ORPA1988/PiLiDAR/hardware/stl27l_mount.stl

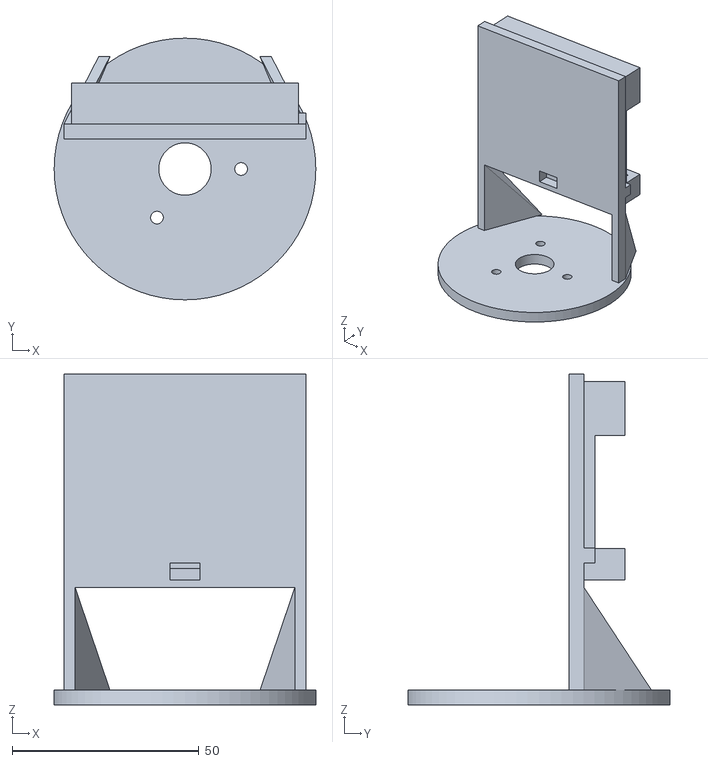
[picture p10: CAD file, 2026-06-21]
hardware/stl27l_mount.stl
70.0 x 70.0 x 88.5
