ORPA1988/PiLiDAR/backend/app.py

"""FastAPI-Server: REST-Steuerung + WebSocket-Rohdatenstream + statisches Frontend.

Start:  uvicorn backend.app:app --host 0.0.0.0 --port 8000
oder:   python -m backend.app
Mock-Modus (ohne Hardware, zum Testen am PC):  PILIDAR_MOCK=1 python -m backend.app
"""

from __future__ import annotations

import asyncio
import os
import subprocess
import time
from pathlib import Path

from fastapi import Body, FastAPI, WebSocket, WebSocketDisconnect
from fastapi.responses import HTMLResponse, JSONResponse, Response
from fastapi.staticfiles import StaticFiles

try:
    import psutil as _psutil
except ImportError:
    _psutil = None

_net_prev: dict = {}  # {iface: (bytes_sent, bytes_recv, timestamp)}

from .config import config
from .controller import ScanController

ROOT = Path(__file__).resolve().parent.parent
FRONTEND = ROOT / "frontend"

FORCE_MOCK = os.environ.get("PILIDAR_MOCK", "0") == "1"

app = FastAPI(title="PiLiDAR", version="2.0")
controller = ScanController(config, force_mock=FORCE_MOCK)

if FORCE_MOCK:
    # Synthetischer LiDAR -> komplette UI ohne Hardware demonstrierbar
    from .hardware.mock_serial import MockLidarSerial
    controller.lidar._serial_factory = lambda: MockLidarSerial()


@app.on_event("startup")
async def _startup():
    controller.bind_loop(asyncio.get_running_loop())


@app.on_event("shutdown")
async def _shutdown():
    controller.close()


# --- REST -------------------------------------------------------------
@app.get("/api/status")
async def api_status():
    return controller.status()


@app.get("/api/config")
async def api_config():
    return config.as_dict()


@app.post("/api/lidar/start")
async def api_lidar_start():
    controller.start_lidar_only()
    return {"ok": True, "state": controller.state}


@app.post("/api/lidar/stop")
async def api_lidar_stop():
    controller.stop_lidar_only()
    return {"ok": True, "state": controller.state}


@app.post("/api/scan/start")
async def api_scan_start(payload: dict | None = None):
    payload = payload or {}
    mode = str(payload.get("mode", "B")).upper()
    name = str(payload.get("name", ""))
    scan_id = controller.start_scan(mode=mode, name=name)
    return {"ok": True, "scan_id": scan_id}


@app.post("/api/scan/stop")
async def api_scan_stop():
    controller.stop()
    return {"ok": True, "state": controller.state}


@app.get("/api/scans")
async def api_scans():
    return controller.store.list_scans()


@app.get("/api/scans/{scan_id}/pointcloud")
async def api_scan_pointcloud(scan_id: str):
    """Gespeicherte Punktwolke für die 3D-Anzeige als kompakter Binär-Buffer.

    Layout (little-endian): uint32 n | float32[n*3] xyz [m] | uint8[n] Intensität.
    Bei Millionen Punkten ist das um Größenordnungen kleiner/schneller als JSON.
    """
    buf = await asyncio.to_thread(controller.store.load_pointcloud_packed, scan_id)
    if len(buf) <= 4:  # nur der n=0-Header => keine Punktwolke
        return JSONResponse(status_code=404, content={"error": "keine Punktwolke"})
    return Response(content=buf, media_type="application/octet-stream")


@app.get("/api/scans/{scan_id}/download")
async def api_scan_download(scan_id: str):
    data = controller.store.zip_bytes(scan_id)
    return Response(content=data, media_type="application/zip",
                    headers={"Content-Disposition": f'attachment; filename="{scan_id}.zip"'})


@app.post("/api/calibrate/rotation")
async def api_cal_rotation():
    result = await asyncio.to_thread(controller.run_rotation_calibration)
    return result


@app.post("/api/calibrate/offset")
async def api_cal_offset():
    result = await asyncio.to_thread(controller.run_offset_calibration)
    return result


@app.get("/api/system/stats")
async def api_system_stats():
    if _psutil is None:
        return {"available": False}
    cpu = _psutil.cpu_percent(interval=None)
    ram = _psutil.virtual_memory().percent
    net: dict = {}
    try:
        counters = _psutil.net_io_counters(pernic=True)
        now = time.monotonic()
        for iface in ("eth0", "wlan0", "bnep0", "end0"):
            if iface not in counters:
                continue
            c = counters[iface]
            if iface in _net_prev:
                prev_sent, prev_recv, prev_t = _net_prev[iface]
                dt = max(1e-3, now - prev_t)
                net[iface] = {
                    "tx_bps": int((c.bytes_sent - prev_sent) / dt),
                    "rx_bps": int((c.bytes_recv - prev_recv) / dt),
                }
            else:
                net[iface] = {"tx_bps": 0, "rx_bps": 0}
            _net_prev[iface] = (c.bytes_sent, c.bytes_recv, now)
    except Exception:
        pass
    return {"available": True, "cpu_percent": cpu, "ram_percent": ram, "net": net}


@app.post("/api/system/reboot")
async def api_reboot():
    subprocess.run(["sudo", "systemctl", "reboot"], check=False)
    return {"ok": True}


@app.post("/api/system/poweroff")
async def api_poweroff():
    subprocess.run(["sudo", "systemctl", "poweroff"], check=False)
    return {"ok": True}


@app.delete("/api/scans/{scan_id}")
async def api_scan_delete(scan_id: str):
    controller.store.delete_scan(scan_id)
    return {"ok": True}


@app.post("/api/scans/{scan_id}/annotation")
async def api_scan_annotation(scan_id: str, payload: dict = Body(...)):
    controller.store.update_annotation(scan_id, str(payload.get("text", "")))
    return {"ok": True}


@app.post("/api/config/apply")
async def api_config_apply(payload: dict):
    """Kalibrierergebnisse übernehmen (z.B. gear_ratio, angle_offset, offsets)."""
    if "gear_ratio" in payload:
        config.update_section("STEPPER", {"GEAR_RATIO": float(payload["gear_ratio"])})
    geom = {}
    if "model_y_offset" in payload:
        geom["MODEL_Y_OFFSET"] = float(payload["model_y_offset"])
    if "model_z_offset" in payload:
        geom["MODEL_Z_OFFSET"] = float(payload["model_z_offset"])
    if geom:
        config.update_section("GEOMETRY", geom)
    if "angle_offset" in payload:
        config.update_section("LIDAR", {"ANGLE_OFFSET": float(payload["angle_offset"])})
    if "overlap_deg" in payload:
        config.update_section("MODE_B_CONTINUOUS", {"OVERLAP_DEG": float(payload["overlap_deg"])})
    return {"ok": True, "config": config.as_dict()}


# --- WebSocket: Rohdaten-Stream --------------------------------------
@app.websocket("/ws/scan")
async def ws_scan(ws: WebSocket):
    await ws.accept()
    q = controller.subscribe()
    # geometrische Parameter einmalig senden, damit der Client rechnen kann
    await ws.send_json({
        "type": "init",
        "angle_offset": config.LIDAR["ANGLE_OFFSET"],
        "model_y": config.GEOMETRY["MODEL_Y_OFFSET"],
        "model_z": config.GEOMETRY["MODEL_Z_OFFSET"],
        "dist_min": config.LIDAR["DISTANCE_MIN_MM"],
        "dist_max": config.LIDAR["DISTANCE_MAX_MM"],
    })
    try:
        while True:
            msg = await q.get()
            await ws.send_json({"type": "frame", **msg})
    except WebSocketDisconnect:
        pass
    finally:
        controller.unsubscribe(q)


# --- statisches Frontend (zuletzt gemountet) -------------------------
if FRONTEND.exists():
    app.mount("/", StaticFiles(directory=str(FRONTEND), html=True), name="frontend")
else:  # pragma: no cover
    @app.get("/")
    async def _root():
        return HTMLResponse("<h1>PiLiDAR</h1><p>Frontend fehlt.</p>")


def main():
    import uvicorn
    uvicorn.run(app, host=config.SERVER["HOST"], port=config.SERVER["PORT"])


if __name__ == "__main__":
    main()
