ORPA1988/PiLiDAR/(commit log)

2025-06-12 Implement relay control and autostart setup
2025-09-17 Add GUI workflow, enhanced LiDAR driver, and documentation overhaul
2026-06-21 PiLiDAR 2.0: Inhalt ersetzt — Web-Steuerung, USB-STL27L, kontinuierliche Drehung
    Vollständige Neuumsetzung (CC BY-NC-SA 4.0):
    - FastAPI-Server (REST + WebSocket), keine Hardware-Knoepfe
    - LiDAR ueber USB; Pi nur Rohdatenerfassung, Client rechnet (WebGL, ohne Install)
    - Modus B: kontinuierliche konstante Drehung via Hardware-PWM (GPIO19)
    - Ein Ordner pro Scan (Rohdaten + Punktwolken), Referenzfahrt, QA, Kalibrierung
    - Parametrischer STL27L-Halter (OpenSCAD) + Doku (Verkabelung, BOM, Konzept)
    [PiLiDAR_BOM_Specs.xlsx, stl27l_mount.scad, stl27l_mount.stl]
2026-06-21 Detailgetreue, pin-genaue Verkabelungspläne (A4988 & TMC2209) ergänzt
    - docs/make_wiring_detailed.py: komplette 40-Pin-Pi-Leiste, voller Treiber-Pinout,
    Kondensatoren an korrekten Knoten, Spulenpaare, Sternmasse, Legende
    - PNG+SVG in docs/images/, ins Konzept-Dokument eingebettet
2026-06-21 Montage- und Scan-Vorgang-Skizze auf technischen Zeichenstil umgestellt
    - lidar_montage: Baugruppen-Schnitt (Y-Z) mit Koordinatentriade, Drehachsen-
    Mittellinie, bemaßtem center_height/axis_offset, Spinachse, Schriftfeld
    - scan_vorgang: Messgeometrie (Scan-Ebene) + Rechenketten-Notizblock, Schriftfeld
    - Konzept-docx mit den neuen technischen Zeichnungen aktualisiert
2026-06-21 Bugfixes, System-Dashboard und Scan-Verwaltung (#31)
    Bugfixes:
    - 3D-Ansicht: _resize() nach Anzeigenwechsel aufrufen + WebGL-Null-Guard
    - QA: Loop-Closure-Residuum wird bei Scans < 350° nicht berechnet (kein falscher Error)
    - Pakete/s: LidarStats.freeze() friert Rate beim Stopp ein (sinkt nicht mehr)
    - Mode A: MAX_PACKAGES wird jetzt tatsächlich abgewartet (Original-Verhalten)
    Neue Features:
    - Dashboard: CPU/RAM/LAN/BT-Bandbreite via psutil (/api/system/stats)
    - Dashboard: LiDAR-Verbindungs-Gesundheitsindikator (grün/gelb/rot)
    - Dashboard: Optimale Mode-B-Geschwindigkeit als Info angezeigt
    - System: Neustart- und Ausschalten-Button (/api/system/reboot, /api/system/poweroff)
    - Scans: Lös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
    [app.py, controller.py, lidar.py, qa.py, storage.py]
2026-06-21 Fix: Mode-B-Geschwindigkeit für gleichen Punktabstand (327 → 1.87 °/s) (#32)
    Der horizontale Punktabstand ergibt sich aus der Plattformdrehung PRO
    LiDAR-Umdrehung (eine vertikale Linie wird nur einmal je Umdrehung
    getroffen), nicht pro Paket. Korrekte Formel:
    SPEED_DPS = Auflösung[°] × Umdrehungsfrequenz[Hz]
    = 0.187° × 10 Hz = 1.87 °/s
    Vorheriger Wert (327 °/s) teilte fälschlich durch die Paketrate und
    hätte ~32.7° Plattformdrehung pro Umdrehung ergeben (extrem grob).
    - config.json: SPEED_DPS 327→1.87, ACCEL_DPS2 1635→10.0
    - app.js: Dashboard-Anzeige der optimalen Geschwindigkeit nutzt jetzt
    die live aus den Frames gemessene Winkelauflösung × Frequenz s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
2026-06-21 LiDAR-Spiegelsteuerung, 3D-Achsen, Scan-Anzeige und 2D/3D-Fix (#33)
    - LiDAR-Spiegel (STL27L): laeuft per Default durch; "0" nur bei "LiDAR stoppen" und Scan-Ende/-Abbruch, "1" nur zum Wieder-Anfahren. Idempotente Motorsteuerung.
    - 2D/3D-Umschaltung repariert (v2d.start/stop, 3D-Resize).
    - 3D-Ansicht: Koordinatenachsen (X/Y/Z) + Labels + Massstab.
    - Gespeicherte Scans in 3D anzeigbar (GET /api/scans/{id}/pointcloud + 3D-Button).
    - Mode-B-Geschwindigkeit 1,67 deg/s (Punktwinkel 0,167 deg x 10 Hz).
    - 2D-Anzeige: Winkel 0 zeigt nach +Y (oben), im Uhrzeigersinn.
    [app.py, controller.py, lidar.py, mock_serial.py, storage.py]
2026-06-22 Fix 3D-Vorzeichen, 2D-Sofortanzeige, Rechte-Hand-Winkel und Overlay-Init (#34)
    * LiDAR-Spiegel-Steuerung, 3D-Achsen und Scan-Anzeige
    - LiDAR-Motor (STL27L) per Seriell schaltbar: b"1"=an, b"0"=aus (921600 Baud).
    Idempotent über _set_motor() – verhindert versehentliches Doppelschalten.
    start()/stop() jetzt re-entrant (kein zweiter Reader-Thread).
    - Controller schaltet den Spiegel beim Übergang 2D-Live -> Scan nicht mehr
    aus/wieder ein; er läuft durchgehend (lidar.start() ist idempotent).
    - 2D/3D-Umschaltung repariert: v2d.start()/stop() beim Moduswechsel, 3D-Resize.
    - 3D-Ansicht: Koordinatenachsen (X rot, Y grün, Z blau) als eigenes WebGL-
    Linienprogramm + HTML-Overlay-Labels u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
    [pointcloud.py]
2026-06-22 3D-Konvention, binäres Punktwolken-Laden und 2D-Vollumdrehung (#35)
    Linienprogramm + HTML-Overlay-Labels und Maßsta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
